MikePythons/smolduino-ohno/smolDuino.kicad_pcb

## KiCad design smolDuino.kicad_pcb (2022-01-14)

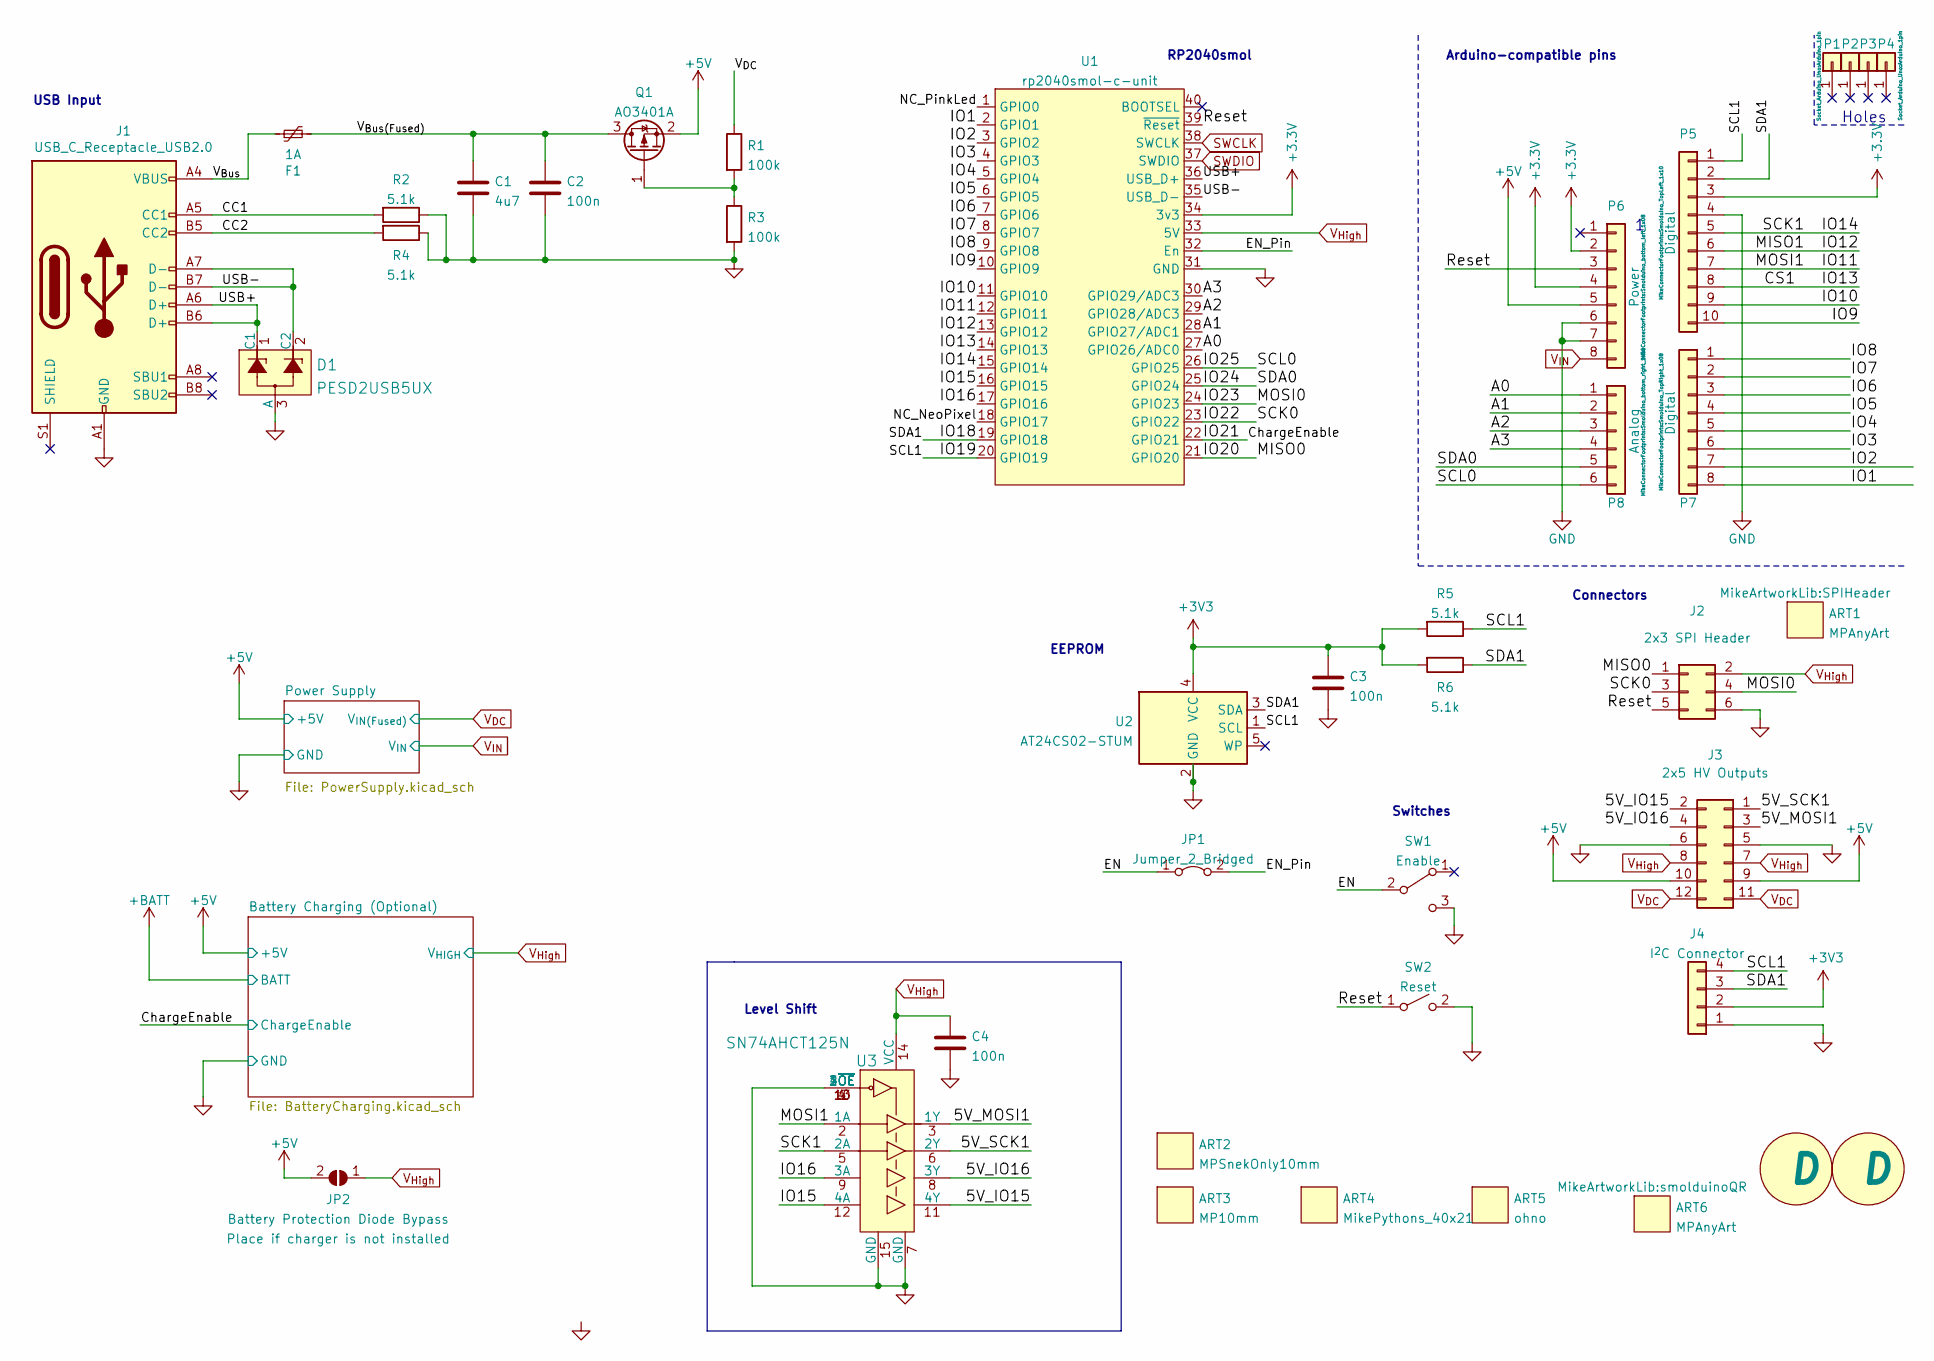
[picture p1: schematic smolDuino.kicad_sch]

Parts:
ART1: MPAnyArt; SPIHeader
ART2: MPSnekOnly10mm; MPSnekOnly_10x6mm
ART3: MP10mm; MPSquare_10mm
ART4: MikePythons_40x21; MikePythons_22x12
ART5: ohno
ART6: MPAnyArt; smolduinoQR
C1: 4u7; C_0805_2012Metric
C2, C3, C4: 100n; C_0603_1608Metric
D1: PESD2USB5UX; SOT-23-3
F1: 1A; Fuse_1206_3216Metric
J1: USB_C_Receptacle_USB2.0; USB_C_Receptacle_Palconn_UTC16-G
J2: 2x3 SPI Header; PinHeader_2x03_P2.54mm_Vertical
J3: 2x5 HV Outputs; PinSocket_2x06_P2.54mm_Vertical
J4: I^{2}C Connector; JST_SH_SM04B-SRSS-TB_1x04-1MP_P1.00mm_Horizontal
JP1: Jumper_2_Bridged; SolderJumper-2_P1.3mm_Bridged_Pad1.0x1.5mm
JP2: Battery Protection Diode Bypass; SolderJumper-2_P1.3mm_Open_TrianglePad1.0x1.5mm
MISC1, MISC2: D; RevisionSymbol
P1, P2, P3, P4: CONN_01X01; Arduino_1pin
P5: Digital; Smolduino_TopLeft_1x10
P6: Power; Smolduino_bottom_left_1x08
P7: Digital; Smolduino_TopRight_1x08
P8: Analog; Smolduino_bottom_right_1x06
Q1: AO3401A; SOT-23
R1, R3: 100k; R_0603_1608Metric
R2, R4, R5, R6: 5.1k; R_0603_1608Metric
SW1: Enable; SW_SPDT_PCM12
SW2: Reset; E-Switch-TL3330AF260QG-MFG
U1: rp2040smol-c-unit; THT_4x10_smol_dual
U2: AT24CS02-STUM; SOT-23-5
U3: SN74AHCT125N; Texas_S-PVQFN-N14; MPN SN74AHCT125N; Digi-Key_PN 296-4655-5-ND

Connections:
+5V: J3.9, J3.10, JP2.2 (B), P6.5, Q1.2 (S); also elsewhere on the board
/5V_IO15: J3.2, U3.11 (4Y)
/5V_IO16: J3.4, U3.8 (3Y)
/5V_MOSI1: J3.3, U3.3 (1Y)
/5V_SCK1: J3.1, U3.6 (2Y)
/A0: P8.1, U1.27 (GPIO26/ADC0)
/A1: P8.2, U1.28 (GPIO27/ADC1)
/A2: P8.3, U1.29 (GPIO28/ADC3)
/A3: P8.4, U1.30 (GPIO29/ADC3)
/CC1: J1.A5 (CC1), R2.2
/CC2: J1.B5 (CC2), R4.2
/CS1: P5.8, U1.14 (GPIO13)
/ChargeEnable: U1.22 (GPIO21); also elsewhere on the board
/EN: JP1.1 (A), SW1.2 (B)
/EN_Pin: JP1.2 (B), U1.32 (En)
/IO1: P7.8, U1.2 (GPIO1)
/IO2: P7.7, U1.3 (GPIO2)
/IO3: P7.6, U1.4 (GPIO3)
/IO4: P7.5, U1.5 (GPIO4)
/IO5: P7.4, U1.6 (GPIO5)
/IO6: P7.3, U1.7 (GPIO6)
/IO7: P7.2, U1.8 (GPIO7)
/IO8: P7.1, U1.9 (GPIO8)
/IO9: P5.10, U1.10 (GPIO9)
/IO10: P5.9, U1.11 (GPIO10)
/IO11: P5.7, U1.12 (GPIO11), U3.2 (1A)
/IO12: P5.6, U1.13 (GPIO12)
/IO14: P5.5, U1.15 (GPIO14), U3.5 (2A)
/IO15: U1.16 (GPIO15), U3.12 (4A)
/IO16: U1.17 (GPIO16), U3.9 (3A)
/IO18: J4.3, P5.2, R6.1, U1.19 (GPIO18), U2.3 (SDA)
/IO19: J4.4, P5.1, R5.1, U1.20 (GPIO19), U2.1 (SCL)
/IO20: J2.1, U1.21 (GPIO20)
/IO22: J2.3, U1.23 (GPIO22)
/IO23: J2.4, U1.24 (GPIO23)
/IO24: P8.5, U1.25 (GPIO24)
/IO25: P8.6, U1.26 (GPIO25)
/NC_NeoPixel: U1.18 (GPIO17)
/NC_PinkLed: U1.1 (GPIO0)
/Reset: J2.5, P6.3, SW2.1 (A), U1.39 (~Reset)
/USB+: D1.1 (C1), J1.A6 (D+), J1.B6 (D+), U1.36 (USB_D+)
/USB-: D1.2 (C2), J1.A7 (D-), J1.B7 (D-), U1.35 (USB_D-)
/V_{Bus}: F1.1, J1.A4 (VBUS), J1.A9 (VBUS), J1.B4 (VBUS), J1.B9 (VBUS)
/V_{Bus}_{(Fused)}: C1.2, C2.1, F1.2, Q1.3 (D)
GND: C1.1, C2.2, C3.2, C4.2, D1.3 (A), J1.A1 (GND), J1.A12 (GND), J1.B1 (GND), J1.B12 (GND), J2.6, J3.5, J3.6, J4.1, P5.4, P6.6, P6.7, R2.1, R3.2, R4.1, SW1.3 (C), SW2.2 (B), U1.31 (GND), U2.2 (GND), U3.1 (1~OE), U3.4 (2~OE), U3.7 (GND), U3.10 (3~OE), U3.13 (4~OE), U3.15 (GND); also elsewhere on the board
unnamed: Q1.1 (G), R1.2, R3.1
SWCLK: U1.38 (SWCLK)
SWDIO: U1.37 (SWDIO)
V_{DC}: J3.11, J3.12, R1.1; also elsewhere on the board
V_{High}: C4.1, J2.2, J3.7, J3.8, JP2.1 (A), U1.33 (5V), U3.14 (VCC); also elsewhere on the board
V_{IN}: P6.8; also elsewhere on the board

Notes on the sheet:
Connectors
Switches
Holes
EEPROM
RP2040smol
Level Shift
Arduino-compatible pins
USB Input

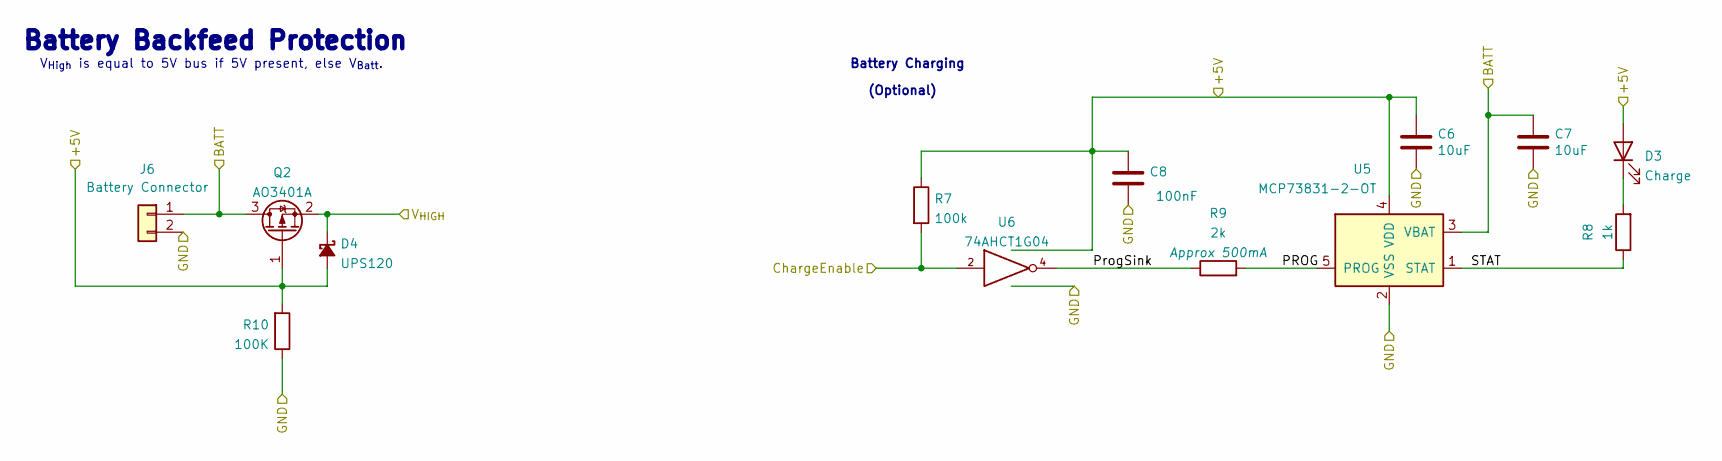
[picture p2: schematic BatteryCharging.kicad_sch]

Parts:
C6, C7: 10uF; C_0805_2012Metric
C8: 100nF; C_0603_1608Metric
D3: Charge; LED_0603_1608Metric
D4: UPS120; UPS120_D_Powermite_AK
J6: Battery Connector; JST_PH_S2B-PH-SM4-TB_1x02-1MP_P2.00mm_Horizontal
Q2: AO3401A; SOT-23
R7: 100k; R_0603_1608Metric
R8: 1k; R_0603_1608Metric
R9: 2k; R_0603_1608Metric
R10: 100K; R_0603_1608Metric
U5: MCP73831-2-OT; SOT-23-5
U6: 74AHCT1G04; SOT-353_SC-70-5

Connections:
+5V: C6.1, C8.1, D3.2 (A), D4.2 (A), Q2.1 (G), R7.1, R10.2, U5.4 (VDD), U6.5 (VCC); also elsewhere on the board
+BATT: C7.1, J6.1, Q2.3 (D), U5.3 (VBAT)
/Battery Charging (Optional)/PROG: R9.2, U5.5 (PROG)
/Battery Charging (Optional)/ProgSink: R9.1, U6.4
/Battery Charging (Optional)/STAT: R8.1, U5.1 (STAT)
/ChargeEnable: R7.2, U6.2; also elsewhere on the board
GND: C6.2, C7.2, C8.2, J6.2, R10.1, U5.2 (VSS), U6.3 (GND); also elsewhere on the board
unnamed: D3.1 (K), R8.2
V_{High}: D4.1 (K), Q2.2 (S); also elsewhere on the board

Notes on the sheet:
Battery Charging
V_{High} is equal to 5V bus if 5V present, else V_{Batt}.
(Optional)
Battery Backfeed Protection

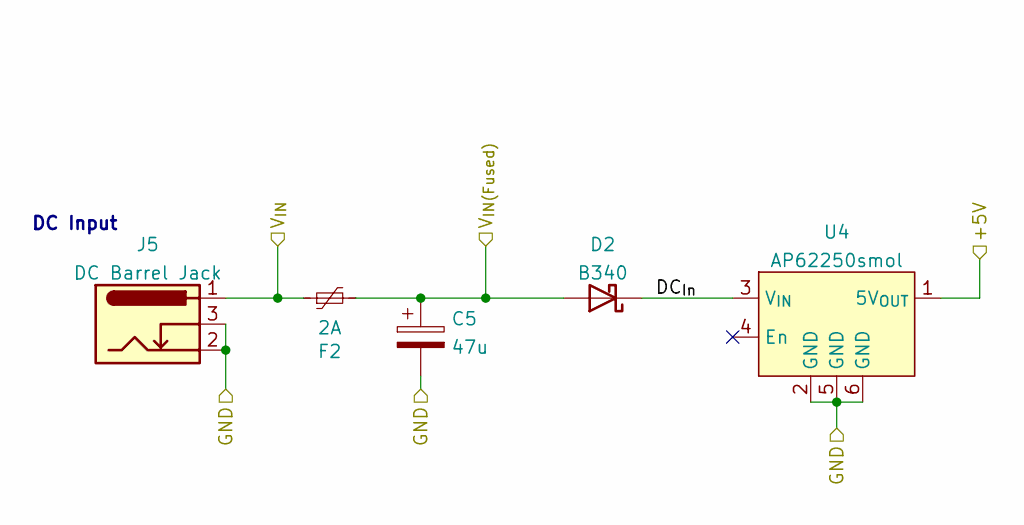
[picture p3: schematic PowerSupply.kicad_sch]

Parts:
C5: 47u; CP_Elec_6.3x5.4
D2: B340; D_SMC
F2: 2A; Fuse_2920_7451Metric
J5: DC Barrel Jack; BarrelJack_GCT_DCJ200-10-A_Horizontal
U4: AP62250smol; AP62250smol_C

Connections:
+5V: U4.1 (5V_{OUT}); also elsewhere on the board
/Power Supply/DC_{In}: D2.1 (K), U4.3 (V_{IN})
GND: C5.2, J5.2, J5.3, U4.2 (GND), U4.5 (GND), U4.6 (GND); also elsewhere on the board
V_{DC}: C5.1, D2.2 (A), F2.2; also elsewhere on the board
V_{IN}: F2.1, J5.1; also elsewhere on the board

Notes on the sheet:
DC Input

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
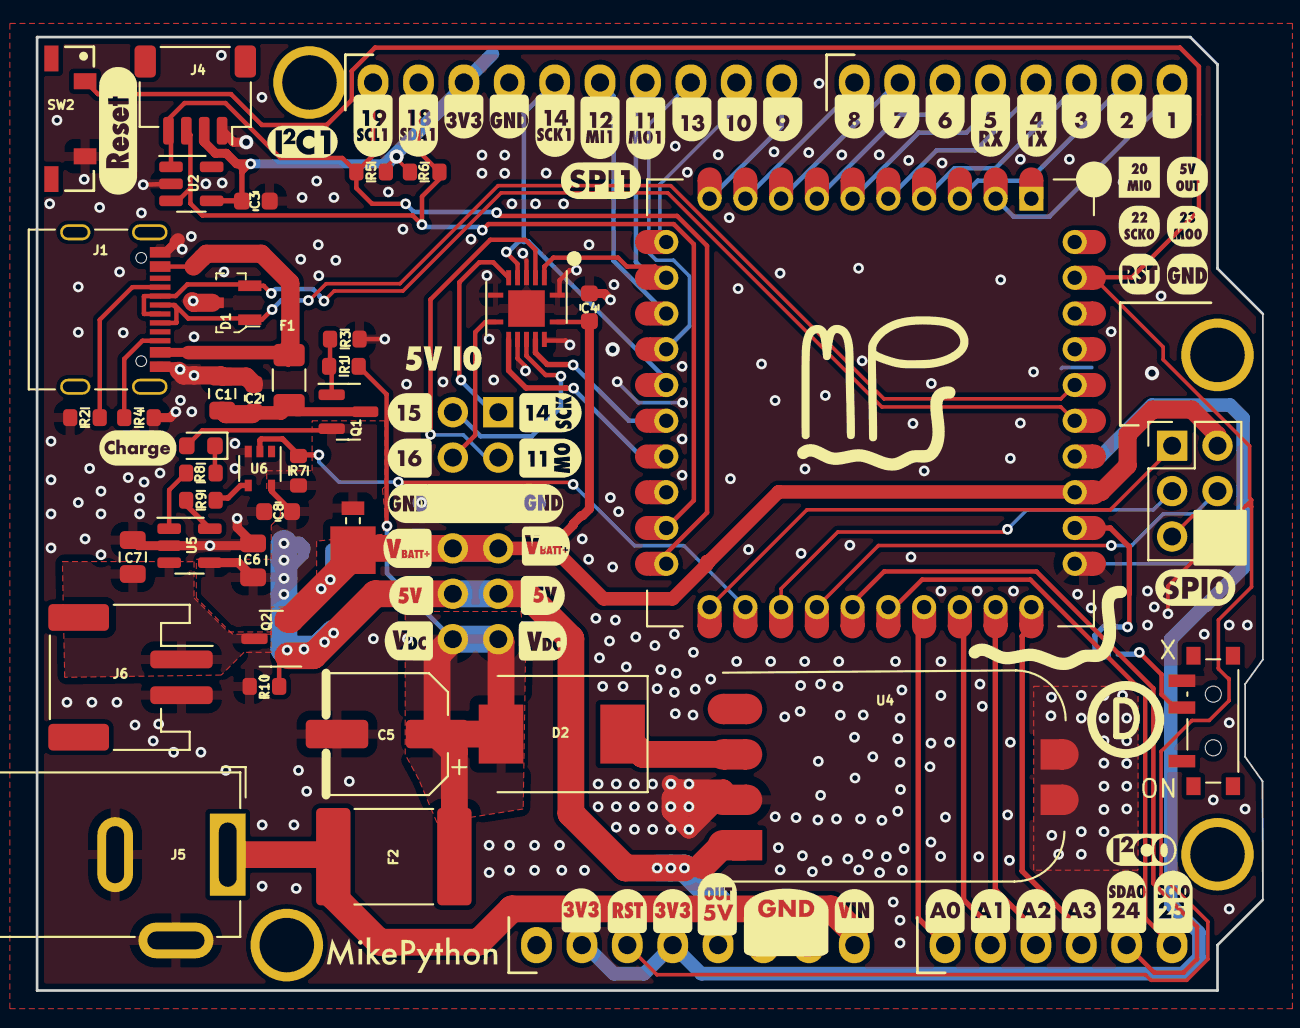
[picture p4: board smolDuino.kicad_pcb from above]

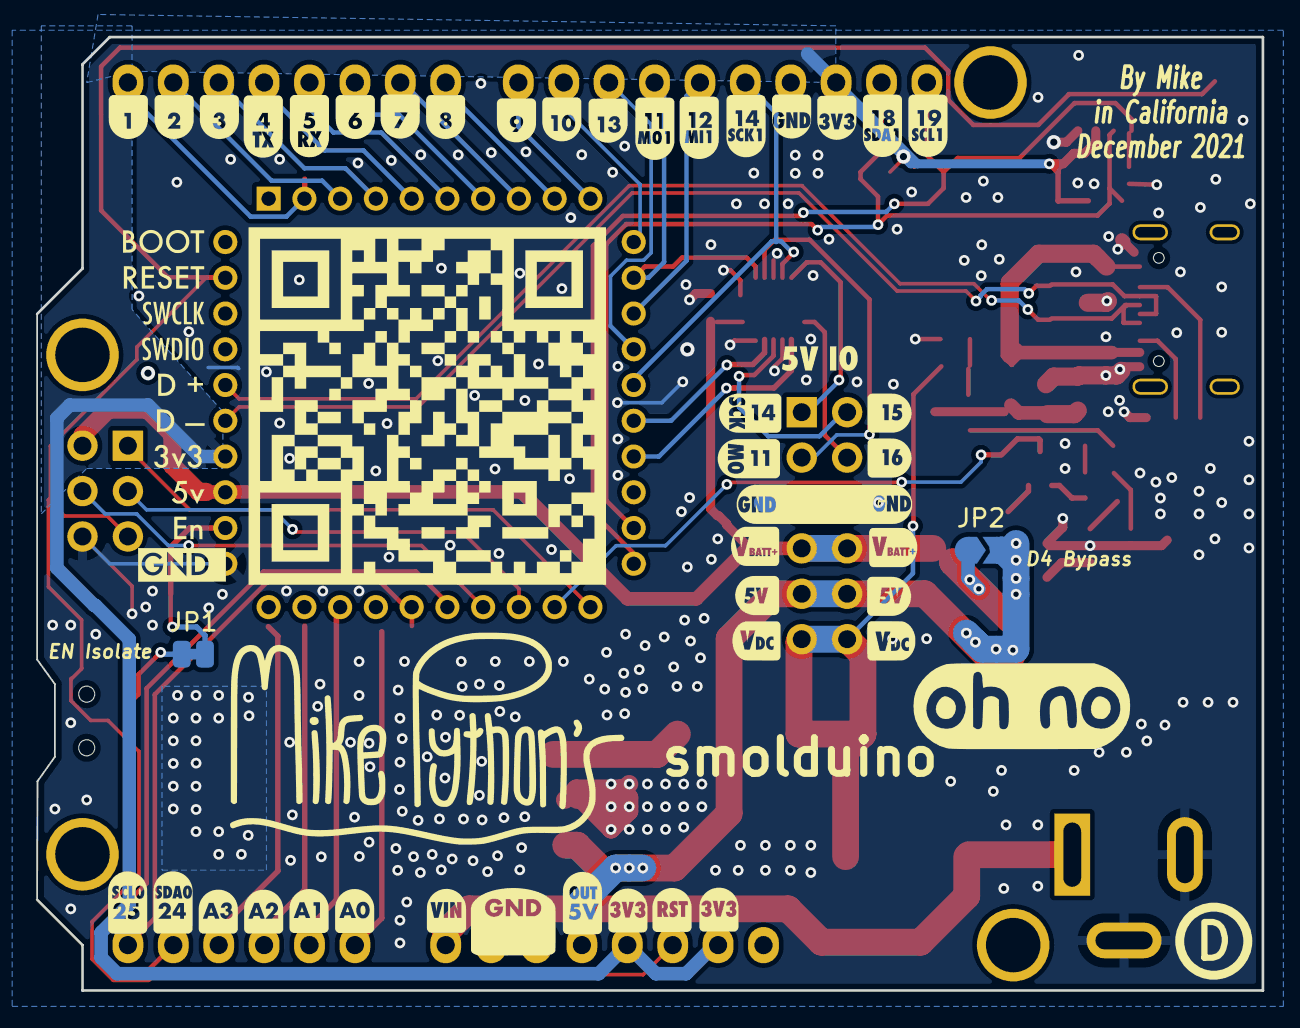
[picture p5: board smolDuino.kicad_pcb from below]

Board: 2 copper layers, 68.6 x 53.3 mm, 58 parts (6 on the bottom side), 54 nets.
