MikePythons/smolduino-ohno/(commit log)

2021-12-25 Initial upload; Rev C in progress and almost ready.
    [smolDuino.kicad_pcb, smolDuino.kicad_sch]
2021-12-30 Removed Charjsmol and integrated the charge circuit directly onto the board. Other than the BGA gas gauge IC (which could be deleted without a huge loss) there's no real reason to put the charger on 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
    [BatteryCharging.kicad_sch, PowerSupply.kicad_sch, smolDuino.kicad_pcb, smolDuino.kicad_sch]
2021-12-30 Adding gerbers
    [smolDuino.kicad_pcb]
2022-01-14 Remove Gas Gauge IC
    [BatteryCharging.kicad_sch, smolDuino.kicad_pcb, smolDuino.kicad_sch]
